pyrodon/303Badge2012/README.md

303Badge2012
============

Project Repository for Badge
