pyrodon/303Badge2012/Schematics/Display-Section.png

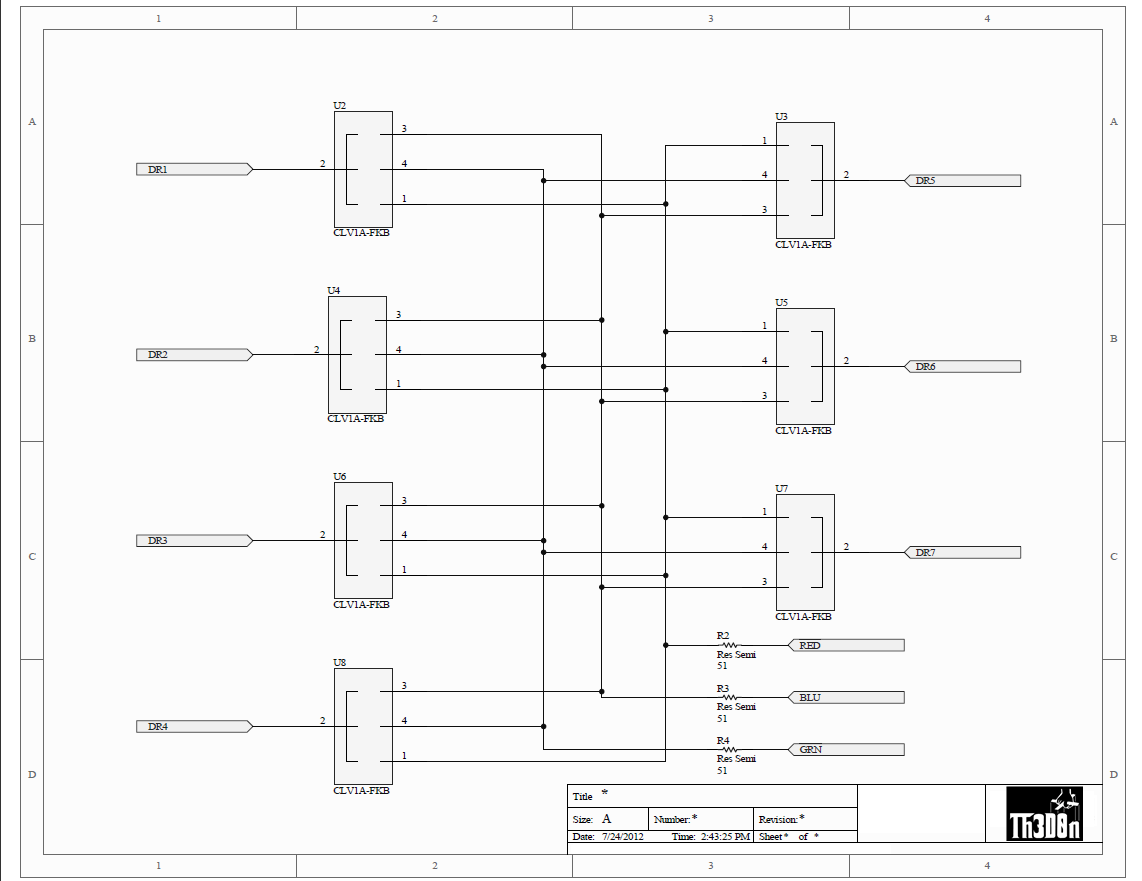
Schematics/Display-Section.png
