pyrodon/303Badge2012/Schematics/ETOH-Section.png

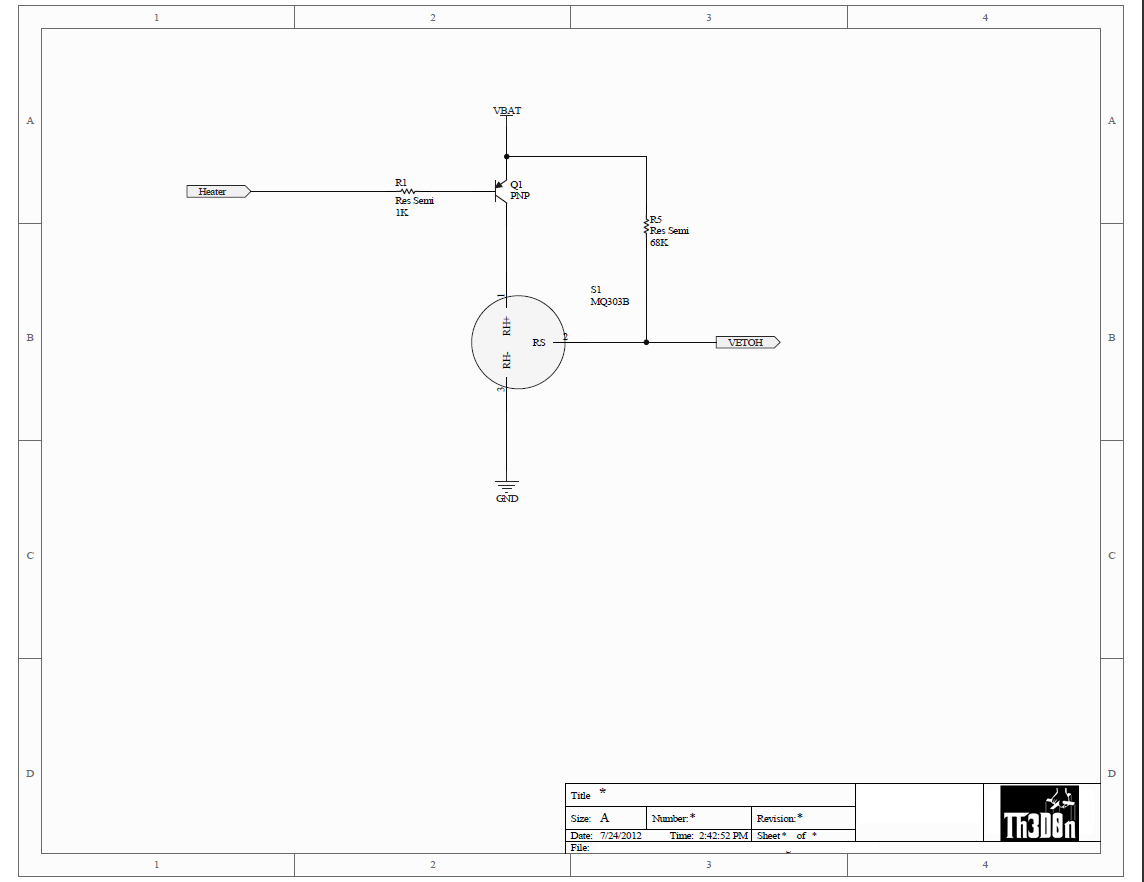
Schematics/ETOH-Section.png
