pyrodon/303Badge2012/Schematics/MenuCtl-Section.png

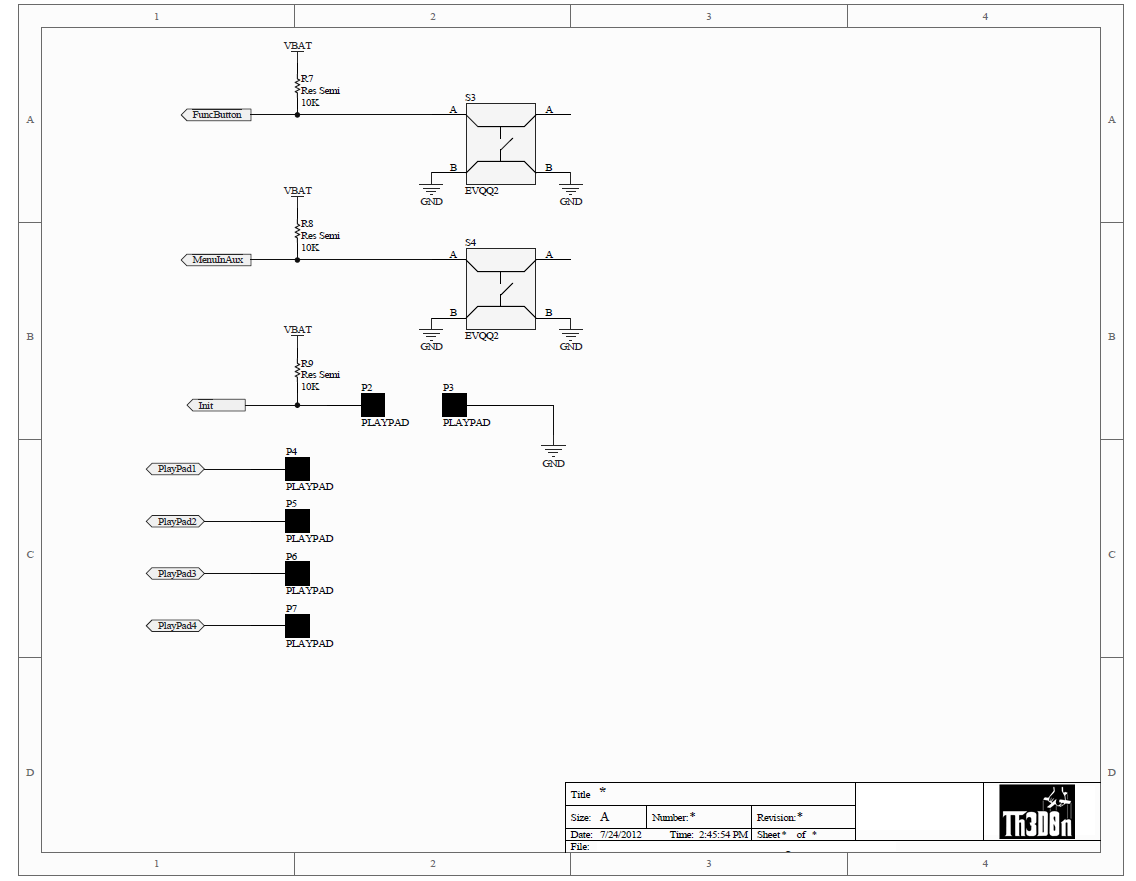
Schematics/MenuCtl-Section.png
