pyrodon/303Badge2012/Schematics/Programming-Section.png

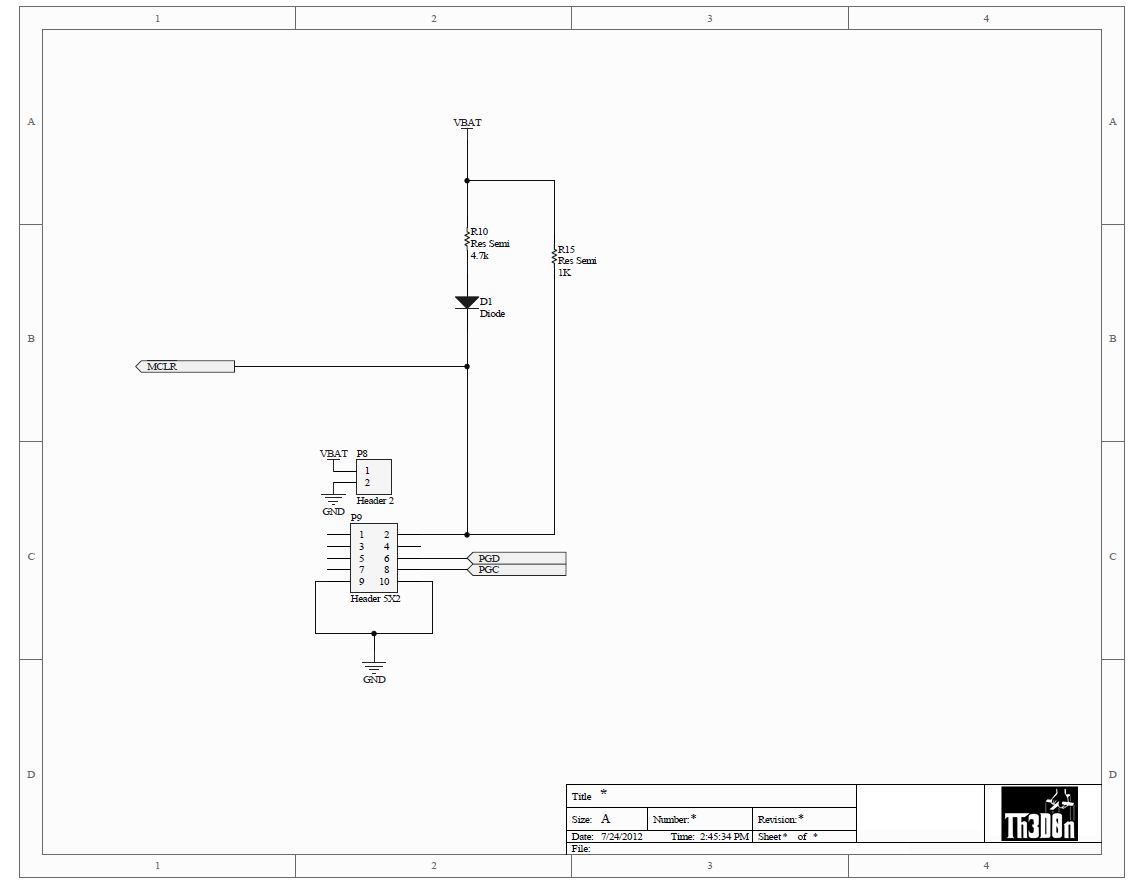
Schematics/Programming-Section.png
