pyrodon/303Badge2012/Schematics/RF-Section.png

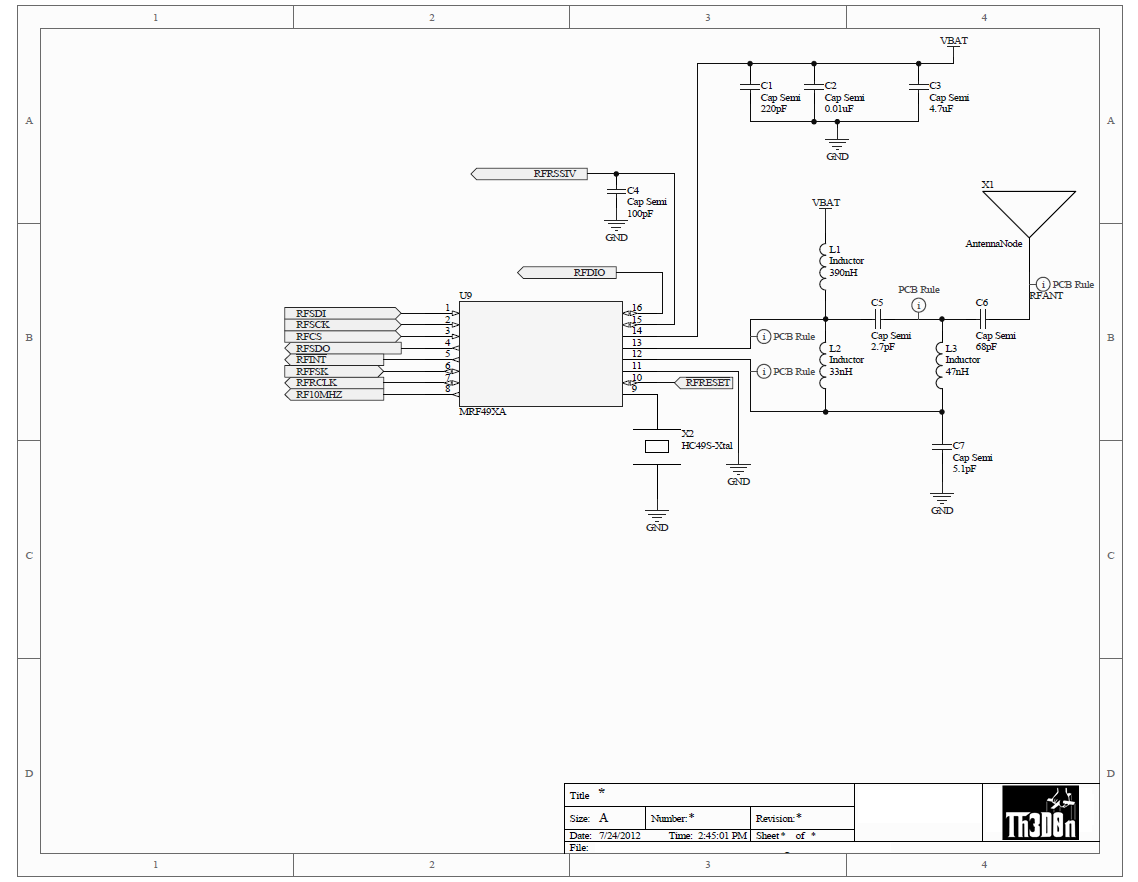
Schematics/RF-Section.png
