pyrodon/303Badge2012/Schematics/Sound-Section.png

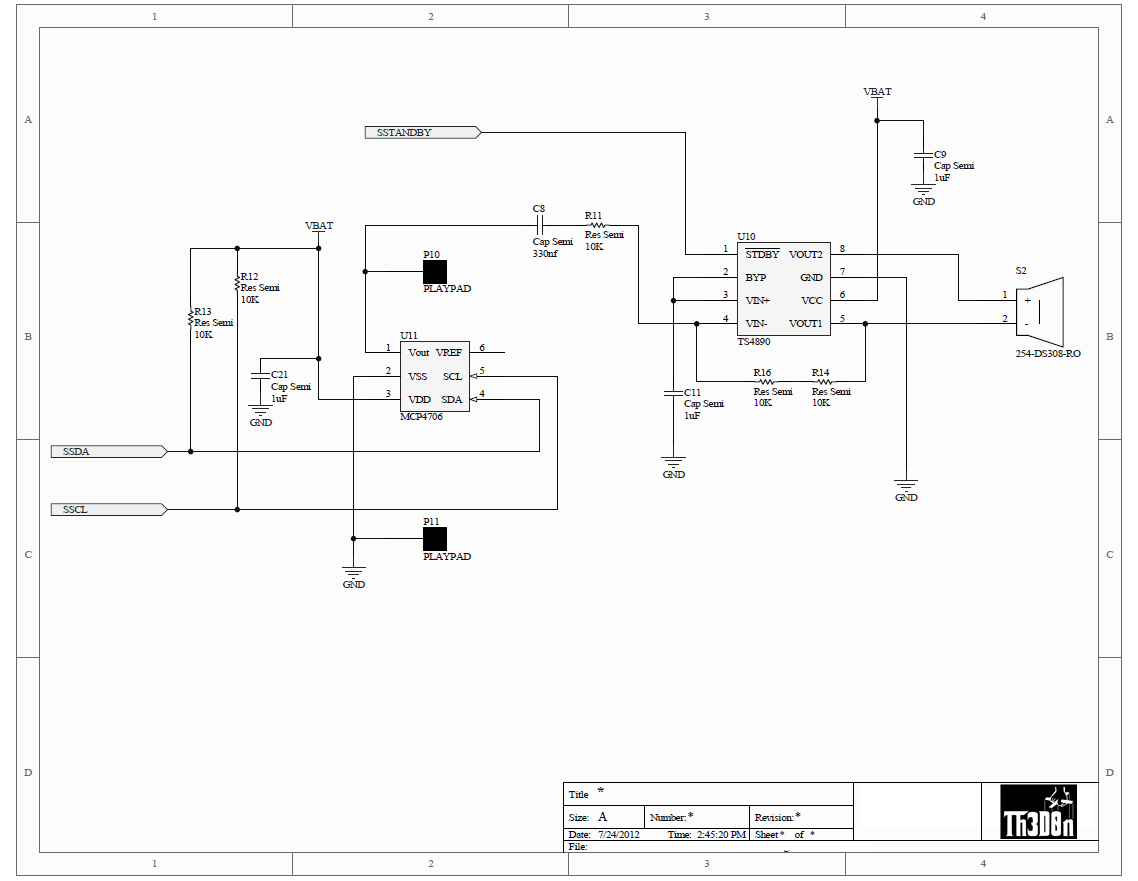
Schematics/Sound-Section.png
