pyrodon/303Badge2012/Schematics/USB-section.png

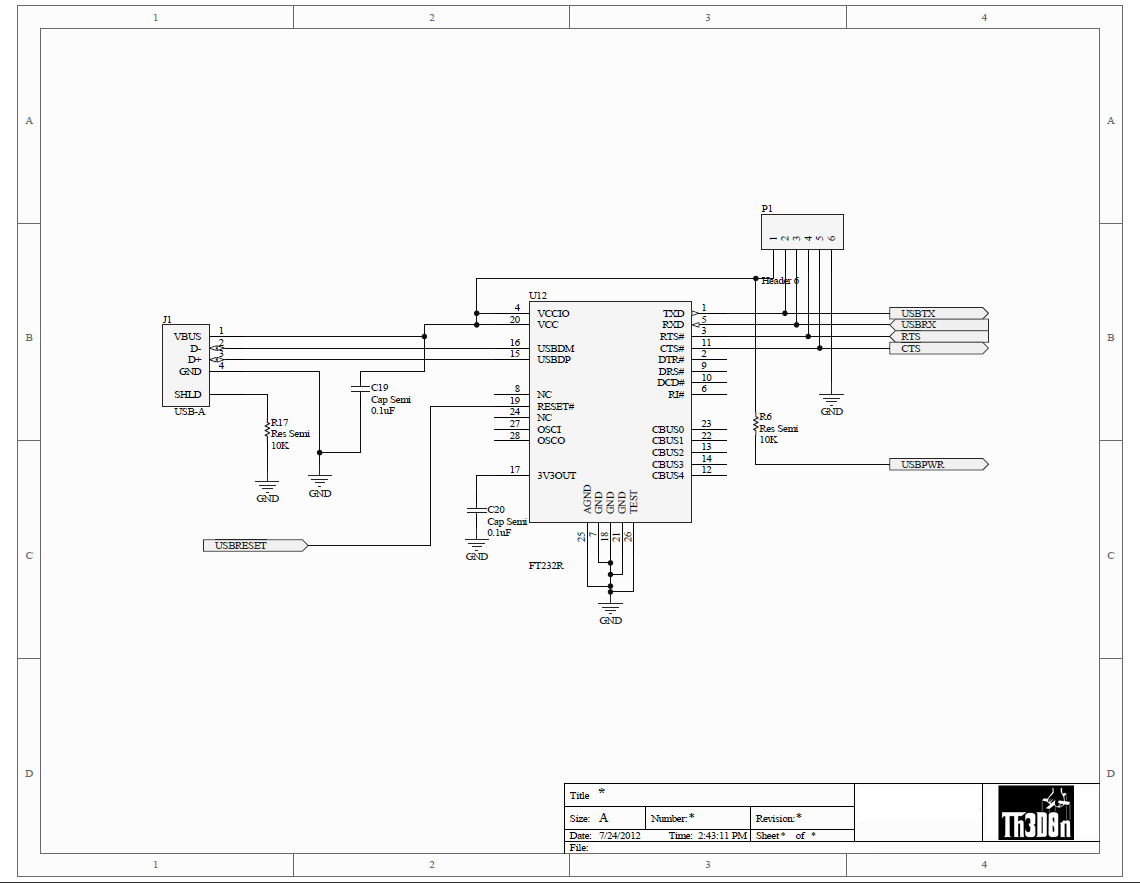
Schematics/USB-section.png
