pyrodon/303Badge2012/(commit log)

2012-07-03 Has working "Dongs" and sample layer (16 bit offset only)
2012-07-14 Edited Remaining Songs
    Complted remaining sogs, started on fixed ETOH Driver
    [Badge.h, ETOH-Driver.c]
2012-07-14 Bad Ptr Arithmetic (compiler?)
    Had an issue doing pointer increments in the interrupt routine. Needed
    to change it back to array references to set the pointer. Think this
    might be a bug in the compiler.
    [ext_chiptune.c, ext_chiptunesong.h, main.c]
2012-07-14 All Songs Selectable
    Incorporated all songs into the data space and made them selectable from
    within the program.
    [AddressCalcs.xlsx]
2012-07-15 Checkpoint
    Checkpoint (working withough weird slowdown caused by buffer naming in
    nvsettings.c nvbuf -> nvolbuf)
    [AddressCalcs.xlsx]
2012-07-15 Checkpoint Bedtime
    Tweaked so that sound and lightshow don't go at once. With more code and
    bank switching, it became too slow to try running sound and lights
    concurrently.
    [Badge.h, POV_Test.c, ext_chiptune.c, main.c, sub_lights.c, sub_samples.c, sub_sound.c]
2012-07-16 Checkpoint - ETOH Sensor
2012-07-21 Checkpoint
    INit button working, NVram still issue.
    [Badge.h, ETOH-Driver.c, main.c, mcu_initcontrol.c, sub_btn.c, sub_lights.c, sub_nvsettings.c, sub_sound.c]
2012-07-22 Checkpoint.. Only button commmands are left
2012-07-24 Final Build for Defcon
    Final Badge Build.. Includes tweaks to the ETOH calibration, the command
    processors, and the timeouts. Final build was with real versusu test
    timeout values (SPEEDTEST not defined).
2012-07-26 Added Comments and Schematics
    Prepped for publishing. Added citations and credits to each file
